quarterturn/squareinator/README.md

squareinator
============

SN76489 MIDI Monosynth
