quarterturn/squareinator/squareinator2.pdf

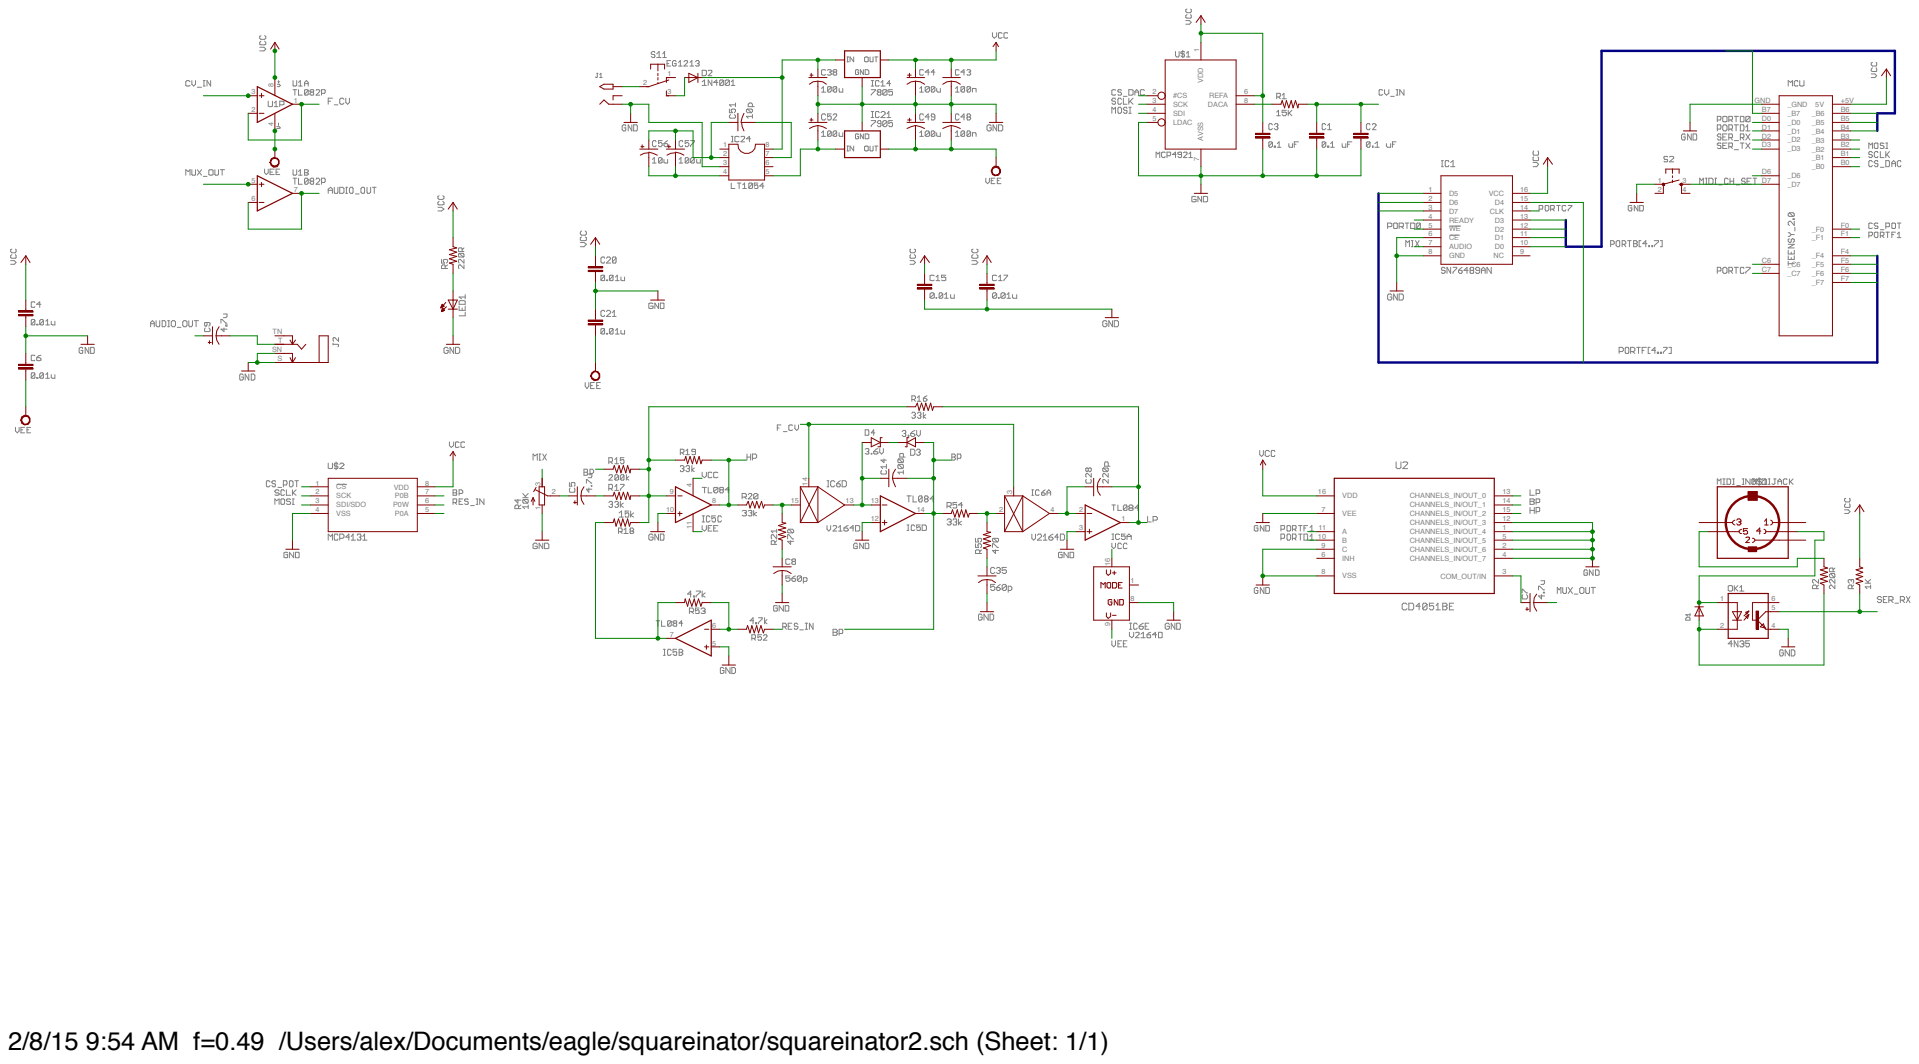
[picture p1: page 1]

2/8/15 9:54 AM f=0.49 /Users/alex/Documents/eagle/squareinator/squareinator2.sch (Sheet: 1/1)
