quarterturn/squareinator/squareinator2.sch

## EAGLE design squareinator2.sch (2015-02-08)

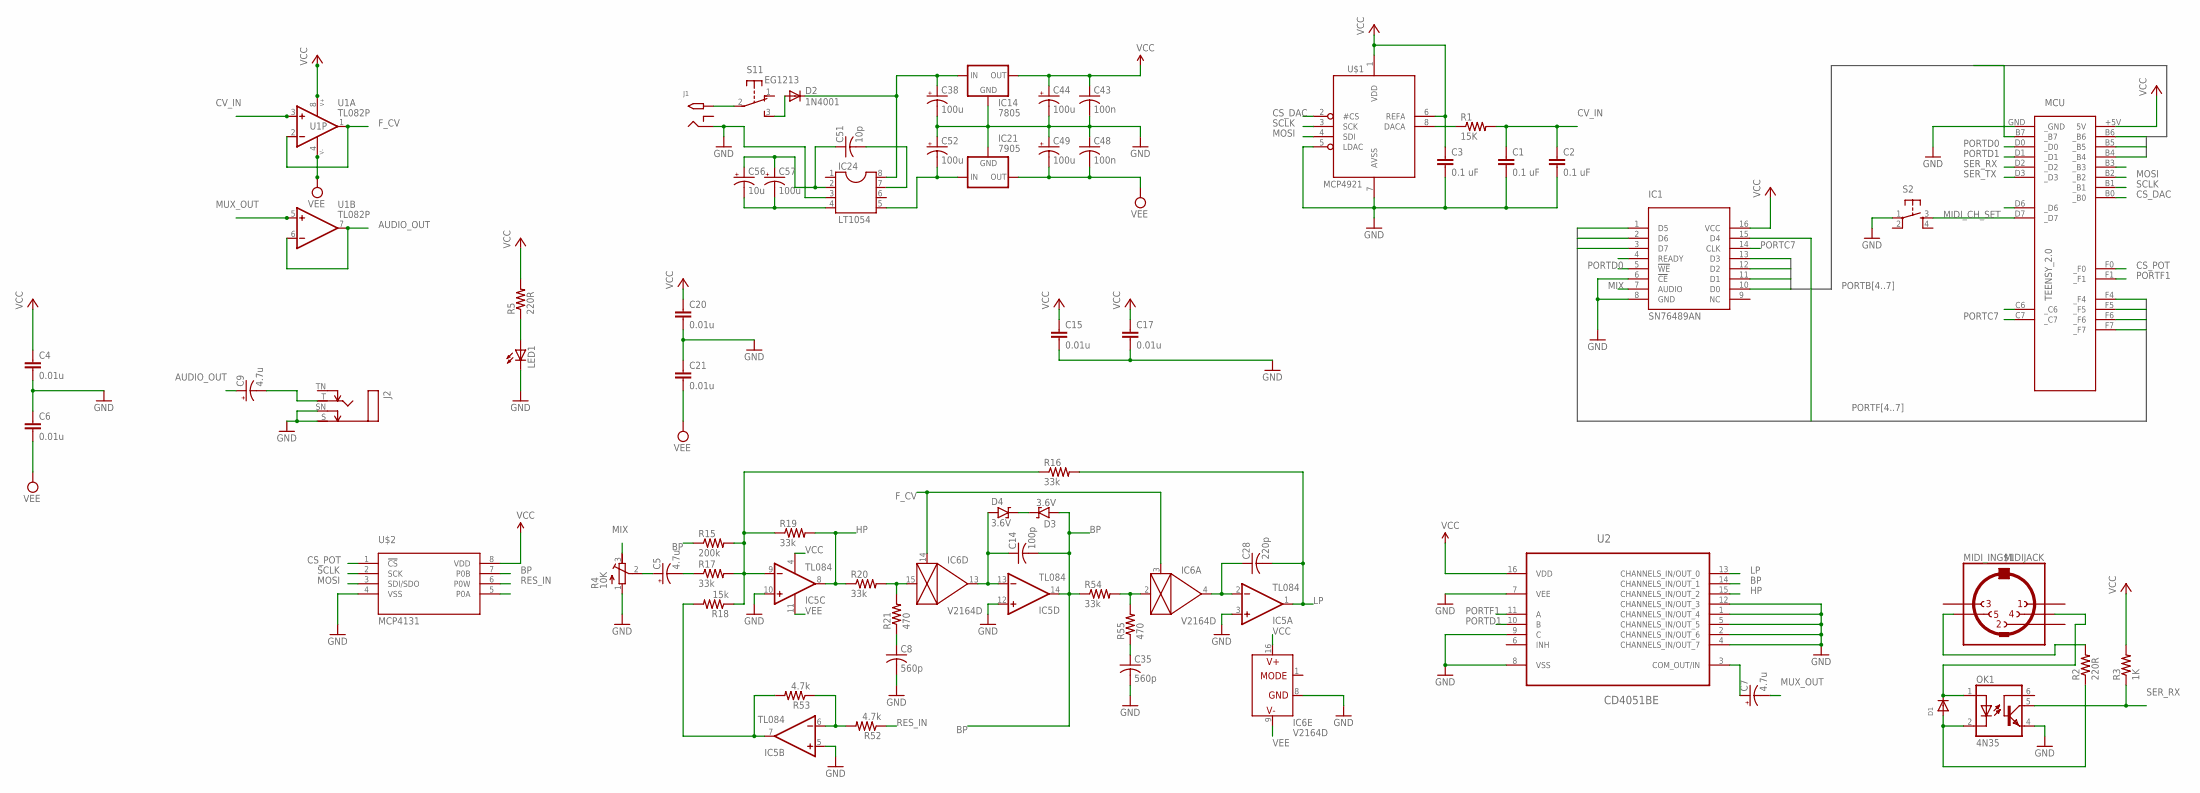
[picture p2: schematic squareinator2.sch]

Parts:
C1, C2, C3: 0.1 uF; CAP-PTH-SMALLEZ
C4, C6, C15, C17, C20, C21: 0.01u; CAP-PTH-SMALLEZ
C5, C7, C9: 4.7u; E2,5-6
C8, C35: 560p; C025-025X050
C14: 100p; C025-025X050
C28: 220p; C025-025X050
C38, C44, C49, C52: 100u; E2,5-7
C43, C48: 100n; C025-025X050
C51: 10p; C025-025X050
C56: 10u; E2,5-5
C57: 100u; E2,5-6
D1: DIODEDO-1N4148; DO-1N4148
D2: 1N4001; DO41-10
D3, D4: 3.6V; D-5
IC1: SN76489AN; DIL16
IC5: TL084; DIL14
IC6: V2164D; DIL16
IC14: 7805; 78XXS
IC21: 7905; 79XXS
IC24: LT1054; DIL08
J1: 2.1MMJACKTHM; PJ-102A
J2: MONOSWS; NMJ4HC-S
LED1: LED3MM
MCU: TEENSY_2.0; TEENSY
MIDI_IN: MIDIJACK; CP-2350
OK1: 4N35; DIL06
R1: 15K; AXIAL-0.3EZ
R2, R5: 220R; AXIAL-0.3EZ
R3: 1K; AXIAL-0.3EZ
R4: 10K; RTRIM3296P
R15: 200k; 0204/7
R16, R17, R19, R20, R54: 33k; 0204/7
R18: 15k; 0204/7
R21, R55: 470; 0204/7
R52, R53: 4.7k; 0204/7
S1: EG1213
S2: TAC_SWITCHPTH; TACTILE-PTH
U1: TL082P; DIL08
U2: CD4051BE; DIP254P762X508-16
U$1: MCP4921; DIL08
U$2: MCP4131; DIL8

Connections:
AUDIO_JACK: C9.-, J2.T
AUDIO_OUT: C9.+, U1.6 (-IN), U1.7 (OUT)
BP: C14.2, D3.A, IC5.14 (OUT), R15.1, R54.1, U2.14 (CHANNELS_IN/OUT_1), U$2.7 (P0B)
CS_DAC: MCU.B0 (_B0), U$1.2 (#CS)
CS_POT: MCU.F0 (_F0), U$2.1 (!CS)
CV_IN: C1.1, C2.1, R1.P$2 (2), U1.3 (+IN)
F_CV: IC6.3 (CTRL), IC6.14 (CTRL), U1.1 (OUT), U1.2 (-IN)
GND: C1.2, C2.2, C3.2, C4.2, C6.1, C8.2, C15.2, C17.2, C20.2, C21.1, C35.2, C38.-, C43.2, C44.-, C48.1, C49.+, C52.+, IC1.6 (!CE), IC1.8 (GND), IC5.3 (+IN), IC5.5 (+IN), IC5.10 (+IN), IC5.12 (+IN), IC6.8 (GND), IC14.GND, IC21.GND, IC24.3, J1.RING, J2.S, J2.SN, LED1.K (C), MCU.GND (_GND), OK1.4 (EMI), R4.1 (A), S2.1, U2.1 (CHANNELS_IN/OUT_4), U2.2 (CHANNELS_IN/OUT_6), U2.4 (CHANNELS_IN/OUT_7), U2.5 (CHANNELS_IN/OUT_5), U2.7 (VEE), U2.8 (VSS), U2.9 (C), U2.12 (CHANNELS_IN/OUT_3), U$1.5 (LDAC), U$1.7 (AVSS), U$2.4 (VSS)
HP: IC5.8 (OUT), R19.2, R20.1, U2.15 (CHANNELS_IN/OUT_2)
LP: C28.2, IC5.1 (OUT), R16.2, U2.13 (CHANNELS_IN/OUT_0)
MIDI_CH_SET: MCU.D7 (_D7), S2.3
MIX: IC1.7 (AUDIO), R4.3 (E)
MOSI: MCU.B2 (_B2), U$1.4 (SDI), U$2.3 (SDI/SDO)
MUX_OUT: C7.-, U1.5 (+IN)
unnamed: R1.P$1 (1), U$1.8 (DACA)
unnamed: LED1.A, R5.P$1 (1)
unnamed: D1.A, OK1.2 (C), R2.P$1 (1)
unnamed: J1.TIP, S1.2
unnamed: D2.A, S1.3 (S)
unnamed: C51.1, C56.+, C57.+, IC24.2
unnamed: IC5.9 (-IN), R15.2, R16.1, R17.2, R18.1, R19.1
unnamed: C28.1, IC5.2 (-IN), IC6.4 (OUT)
unnamed: C8.1, R21.1
unnamed: D1.C, MIDI_IN.4, OK1.1 (A)
unnamed: IC5.6 (-IN), R52.2, R53.1
unnamed: IC5.7 (OUT), R18.2, R53.2
unnamed: C5.-, R17.1
unnamed: C7.+, U2.3 (COM_OUT/IN)
unnamed: C35.1, R55.1
unnamed: C14.1, D4.A, IC5.13 (-IN), IC6.13 (OUT)
unnamed: C38.+, D2.C, IC14.IN, IC24.8
unnamed: C52.-, IC21.IN, IC24.5
unnamed: IC6.2 (IN), R54.2, R55.2
unnamed: IC6.15 (IN), R20.2, R21.2
unnamed: MIDI_IN.5, R2.P$2 (2)
unnamed: C5.+, R4.2 (S)
unnamed: C56.-, C57.-, IC24.4
unnamed: C51.2, IC24.7
unnamed: D3.C, D4.C
PORTB3: MCU.B3 (_B3)
PORTB4: IC1.10 (D0), MCU.B4 (_B4)
PORTB5: IC1.11 (D1), MCU.B5 (_B5)
PORTB6: IC1.12 (D2), MCU.B6 (_B6)
PORTB7: IC1.13 (D3), MCU.B7 (_B7)
PORTC7: IC1.14 (CLK), MCU.C7 (_C7)
PORTD0: IC1.5 (!WE), MCU.D0 (_D0)
PORTD1: MCU.D1 (_D1), U2.10 (B)
PORTF1: MCU.F1 (_F1), U2.11 (A)
PORTF4: IC1.15 (D4), MCU.F4 (_F4)
PORTF5: IC1.1 (D5), MCU.F5 (_F5)
PORTF6: IC1.2 (D6), MCU.F6 (_F6)
PORTF7: IC1.3 (D7), MCU.F7 (_F7)
RES_IN: R52.1, U$2.6 (P0W)
SCLK: MCU.B1 (_B1), U$1.3 (SCK), U$2.2 (SCK)
SER_RX: MCU.D2 (_D2), OK1.5 (COL), R3.P$1 (1)
SER_TX: MCU.D3 (_D3)
VCC: C3.1, C4.1, C15.1, C17.1, C20.1, C43.1, C44.+, IC1.16 (VCC), IC5.4 (V+), IC6.16 (V+), IC14.OUT, MCU.+5V (5V), R3.P$2 (2), R5.P$2 (2), U1.8 (V+), U2.16 (VDD), U$1.1 (VDD), U$1.6 (REFA), U$2.8 (VDD)
VEE: C6.2, C21.2, C48.2, C49.-, IC5.11 (V-), IC6.9 (V-), IC21.OUT, U1.4 (V-)
