quarterturn/squareinator/(commit log)

2014-07-19 Added BOM
2015-02-08 Added schematic
    [squareinator2.sch]
