quarterturn/squareinator/(notices)

Notices in the files:
parts and their libraries:
SparkFun-Electromechanical: Licensing: CC v3.0 Share-Alike You are welcome to use this library for commercial purposes.
SparkFun-Capacitors: Licensing: Creative Commons ShareAlike 4.0 International - https://creativecommons.org/licenses/by-sa/4.0
op-amp: Copyright (C) 2006 by Bob Starr
